marekw1986/MOS6502_computer/hardware/video_and_power.brd

## EAGLE design hardware/video_and_power.brd (2020-09-18)

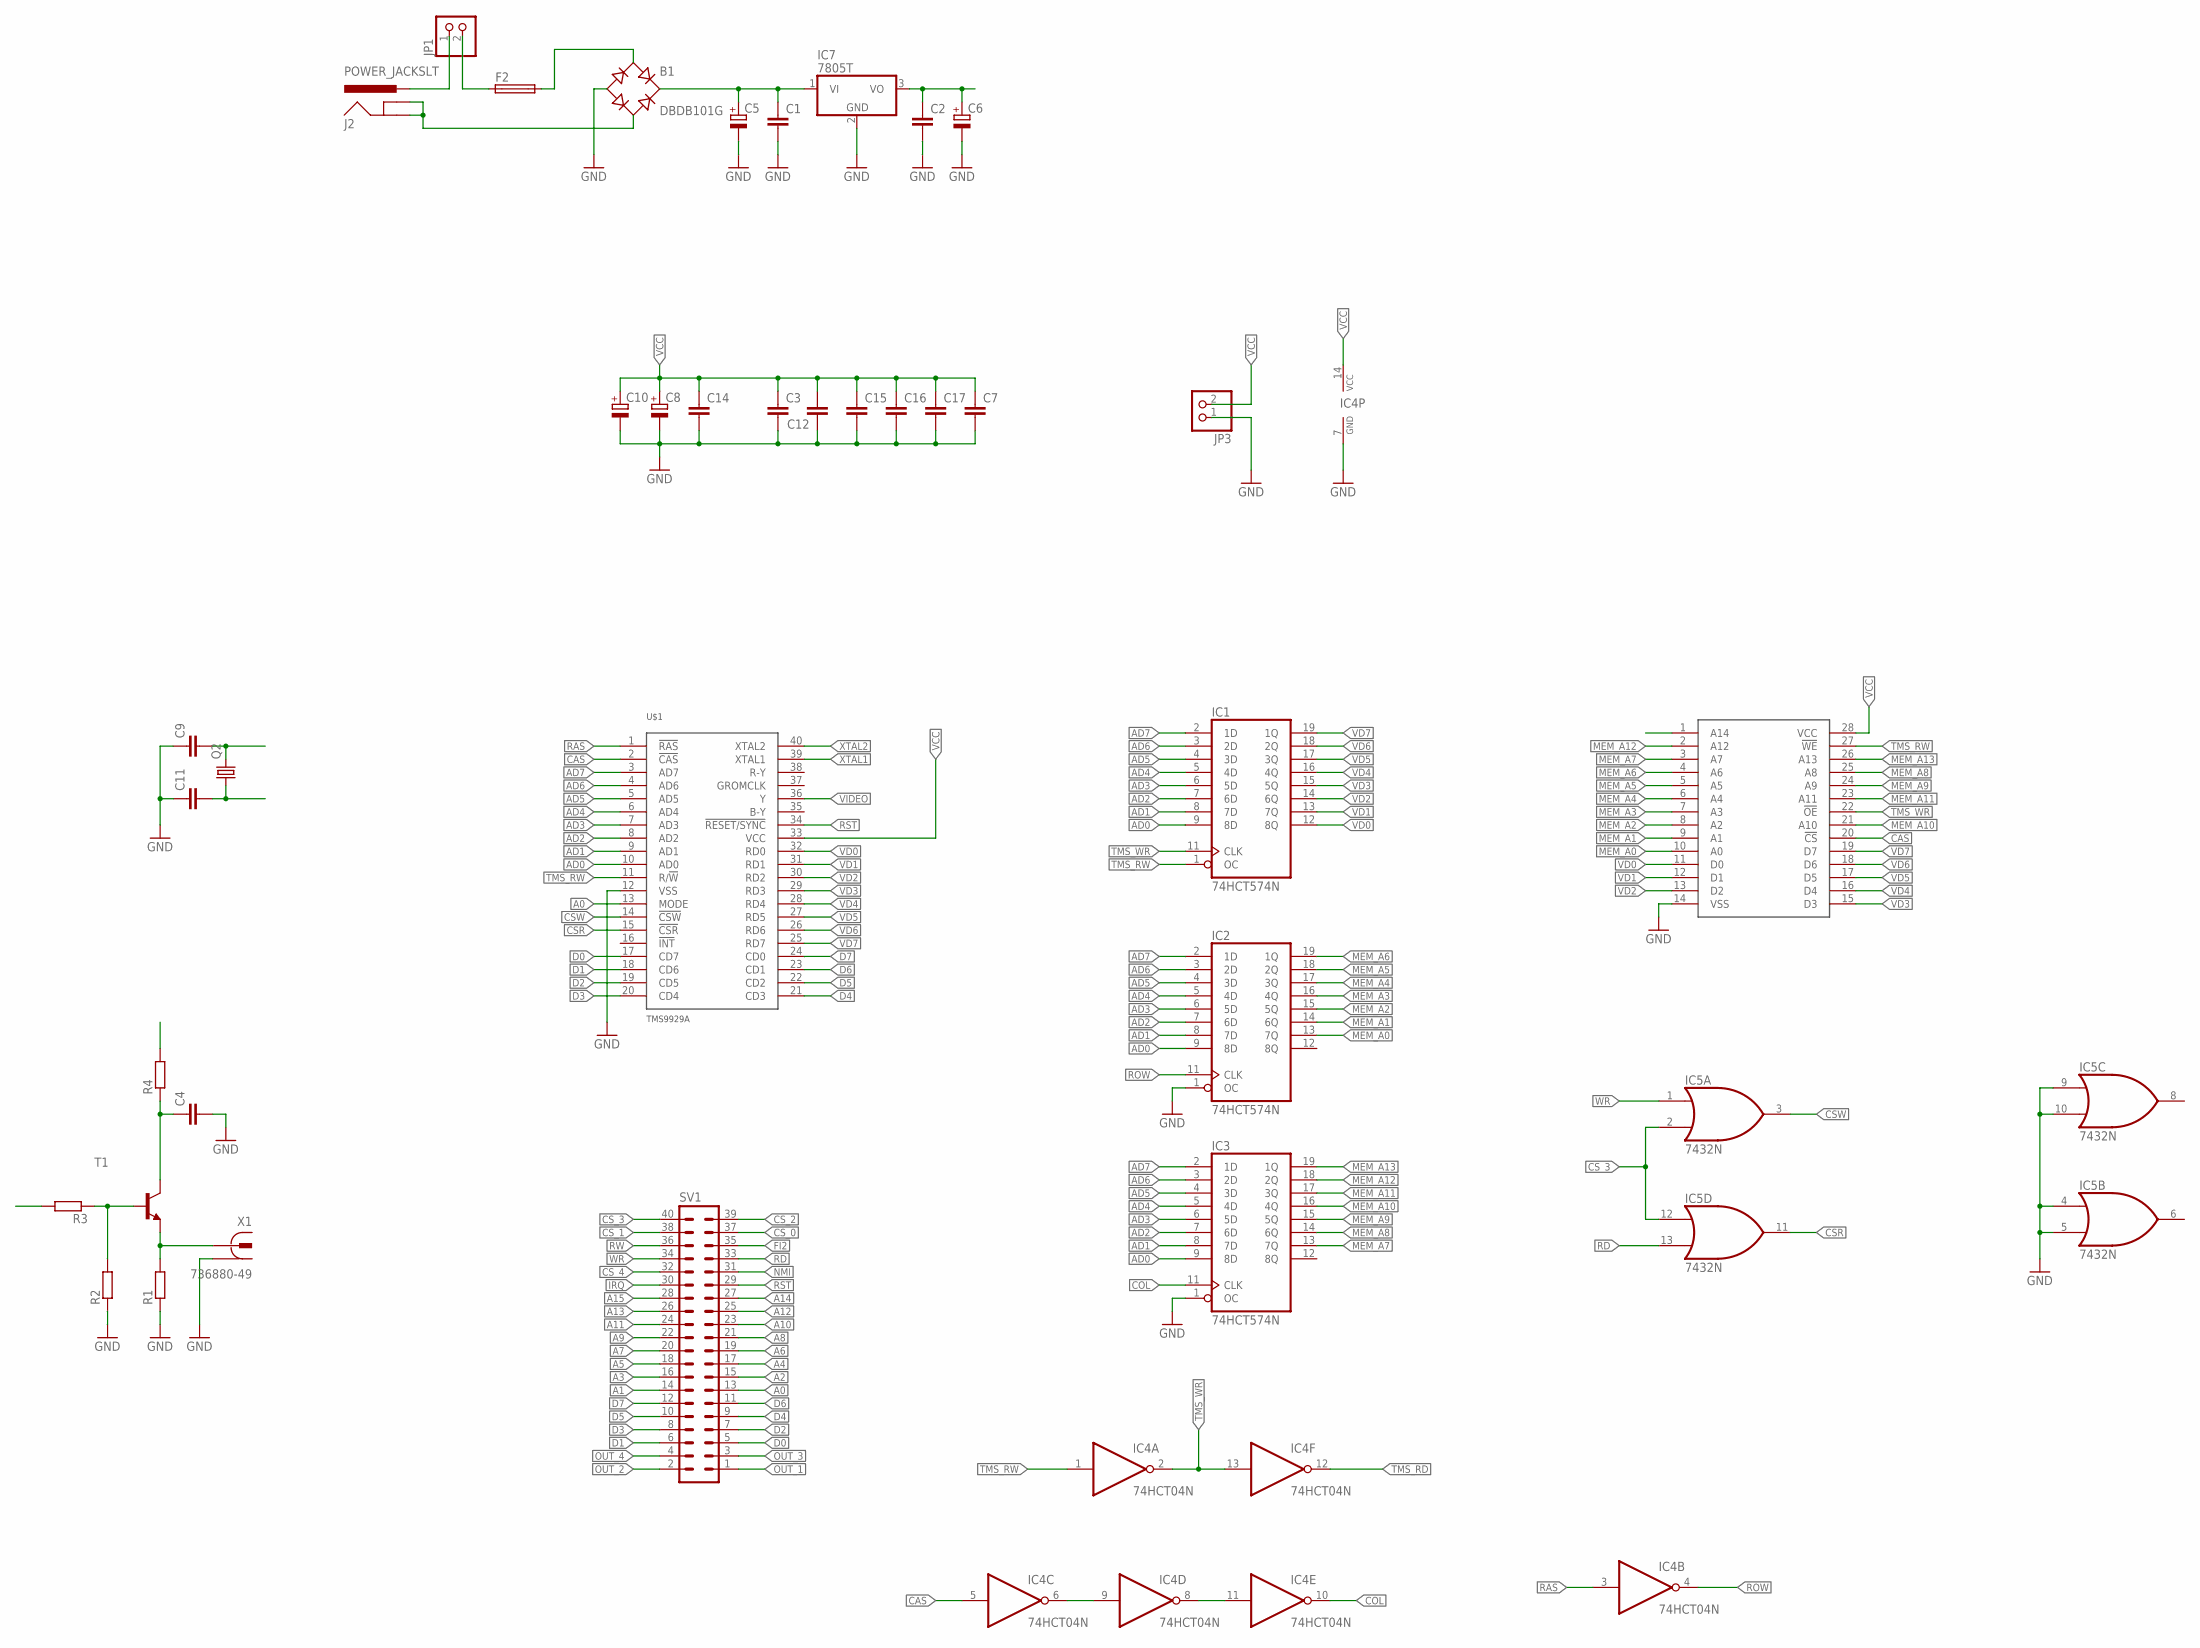
[picture p1: schematic video_and_power.sch]

Parts:
B1: DBDB101G; DB
C1, C2, C7, C14, C15: C-EUC1206; C1206
C3, C4, C9, C11, C12, C16, C17: C-EUC0603; C0603
C5, C6, C8, C10: CPOL-EUE5-10.5; E5-10,5
F2: SH22,5; MPN 0031.8201
IC1, IC2, IC3: 74HCT574N; DIL20
IC4: 74HCT04N; DIL14
IC5: 7432N; DIL14
IC7: 7805T; TO220H
J2: POWER_JACKSLT; POWER_JACK_SLOT
JP1: PINHD-1X2; 1X02
JP3: PINHD-1X2/90; 1X02/90
Q2: CRYSTALHC49S; HC49/S
R1, R2: R-EU_R0603; R0603
R3: R-EU_0204/7; 0204/7
R4: R-EU_R0805; R0805
SV1: ML40L
T1: 2N4401-NPN-TO92-EBC; TO92-EBC
U$1: TMS9929A; DIL40
U$2: 62256; DIL28-6
X1: 736880-49

Connections:
A0: SV1.13, U$1.13 (MODE)
A1: SV1.14
A2: SV1.15
A3: SV1.16
A4: SV1.17
A5: SV1.18
A6: SV1.19
A7: SV1.20
A8: SV1.21
A9: SV1.22
A10: SV1.23
A11: SV1.24
A12: SV1.25
A13: SV1.26
A14: SV1.27
A15: SV1.28
AD0: IC1.9 (8D), IC2.9 (8D), IC3.9 (8D), U$1.10 (AD0)
AD1: IC1.8 (7D), IC2.8 (7D), IC3.8 (7D), U$1.9 (AD1)
AD2: IC1.7 (6D), IC2.7 (6D), IC3.7 (6D), U$1.8 (AD2)
AD3: IC1.6 (5D), IC2.6 (5D), IC3.6 (5D), U$1.7 (AD3)
AD4: IC1.5 (4D), IC2.5 (4D), IC3.5 (4D), U$1.6 (AD4)
AD5: IC1.4 (3D), IC2.4 (3D), IC3.4 (3D), U$1.5 (AD5)
AD6: IC1.3 (2D), IC2.3 (2D), IC3.3 (2D), U$1.4 (AD6)
AD7: IC1.2 (1D), IC2.2 (1D), IC3.2 (1D), U$1.3 (AD7)
CAS: IC4.5 (I), U$1.2 (!CAS), U$2.20 (!CS)
COL: IC3.11 (CLK), IC4.10 (O)
CSR: IC5.11 (O), U$1.15 (!CSR)
CSW: IC5.3 (O), U$1.14 (!CSW)
CS_0: SV1.37
CS_1: SV1.38
CS_2: SV1.39
CS_3: IC5.2 (I1), IC5.12 (I0), SV1.40
CS_4: SV1.32
D0: SV1.5, U$1.17 (CD7)
D1: SV1.6, U$1.18 (CD6)
D2: SV1.7, U$1.19 (CD5)
D3: SV1.8, U$1.20 (CD4)
D4: SV1.9, U$1.21 (CD3)
D5: SV1.10, U$1.22 (CD2)
D6: SV1.11, U$1.23 (CD1)
D7: SV1.12, U$1.24 (CD0)
FI2: SV1.35
GND: B1.-, C1.2, C2.2, C3.2, C4.2, C5.-, C6.-, C7.2, C8.-, C9.1, C10.-, C11.1, C12.1, C14.2, C15.2, C16.2, C17.2, IC1.10 (GND), IC2.1 (OC), IC2.10 (GND), IC3.1 (OC), IC3.10 (GND), IC4.7 (GND), IC5.4 (I0), IC5.5 (I1), IC5.7 (GND), IC5.9 (I0), IC5.10 (I1), IC7.2 (GND), JP3.1, R1.1, R2.1, U$1.12 (VSS), U$2.14 (VSS), X1.1, X1.1@1 (1), X1.1@2 (1)
IRQ: SV1.30
MEM_A0: IC2.13 (7Q), U$2.10 (A0)
MEM_A1: IC2.14 (6Q), U$2.9 (A1)
MEM_A2: IC2.15 (5Q), U$2.8 (A2)
MEM_A3: IC2.16 (4Q), U$2.7 (A3)
MEM_A4: IC2.17 (3Q), U$2.6 (A4)
MEM_A5: IC2.18 (2Q), U$2.5 (A5)
MEM_A6: IC2.19 (1Q), U$2.4 (A6)
MEM_A7: IC3.13 (7Q), U$2.3 (A7)
MEM_A8: IC3.14 (6Q), U$2.25 (A8)
MEM_A9: IC3.15 (5Q), U$2.24 (A9)
MEM_A10: IC3.16 (4Q), U$2.21 (A10)
MEM_A11: IC3.17 (3Q), U$2.23 (A11)
MEM_A12: IC3.18 (2Q), U$2.2 (A12)
MEM_A13: IC3.19 (1Q), U$2.26 (A13)
unnamed: IC4.6 (O), IC4.9 (I)
unnamed: IC4.8 (O), IC4.11 (I)
unnamed: B1.AC1, F2.2
unnamed: J2.PWR, JP1.1
unnamed: R1.2, T1.E, X1.2
unnamed: R2.2, R3.1, T1.B
unnamed: C4.1, R4.1, T1.C
unnamed: B1.AC2, J2.GND@1 (GNDBREAK), J2.GND@2 (GND)
unnamed: F2.1, JP1.2
unnamed: B1.+, C1.1, C5.+, IC7.1 (VI)
NMI: SV1.31
OUT_1: SV1.1
OUT_2: SV1.2
OUT_3: SV1.3, U$2.1 (A14)
OUT_4: SV1.4
RAS: IC4.3 (I), U$1.1 (!RAS)
RD: IC5.13 (I1), SV1.33
ROW: IC2.11 (CLK), IC4.4 (O)
RST: SV1.29, U$1.34 (!RESET/SYNC)
RW: SV1.36
TMS_RD: IC4.12 (O)
TMS_RW: IC1.1 (OC), IC4.1 (I), U$1.11 (R/!W), U$2.27 (!WE)
TMS_WR: IC1.11 (CLK), IC4.2 (O), IC4.13 (I), U$2.22 (!OE)
VCC: C2.1, C3.1, C6.+, C7.1, C8.+, C10.+, C12.2, C14.1, C15.1, C16.1, C17.1, IC1.20 (VCC), IC2.20 (VCC), IC3.20 (VCC), IC4.14 (VCC), IC5.14 (VCC), IC7.3 (VO), JP3.2, R4.2, U$1.33 (VCC), U$2.28 (VCC)
VD0: IC1.12 (8Q), U$1.32 (RD0), U$2.11 (D0)
VD1: IC1.13 (7Q), U$1.31 (RD1), U$2.12 (D1)
VD2: IC1.14 (6Q), U$1.30 (RD2), U$2.13 (D2)
VD3: IC1.15 (5Q), U$1.29 (RD3), U$2.15 (D3)
VD4: IC1.16 (4Q), U$1.28 (RD4), U$2.16 (D4)
VD5: IC1.17 (3Q), U$1.27 (RD5), U$2.17 (D5)
VD6: IC1.18 (2Q), U$1.26 (RD6), U$2.18 (D6)
VD7: IC1.19 (1Q), U$1.25 (RD7), U$2.19 (D7)
VIDEO: R3.2, U$1.36 (Y)
WR: IC5.1 (I0), SV1.34
XTAL1: C9.2, Q2.2, U$1.39 (XTAL1)
XTAL2: C11.2, Q2.1, U$1.40 (XTAL2)

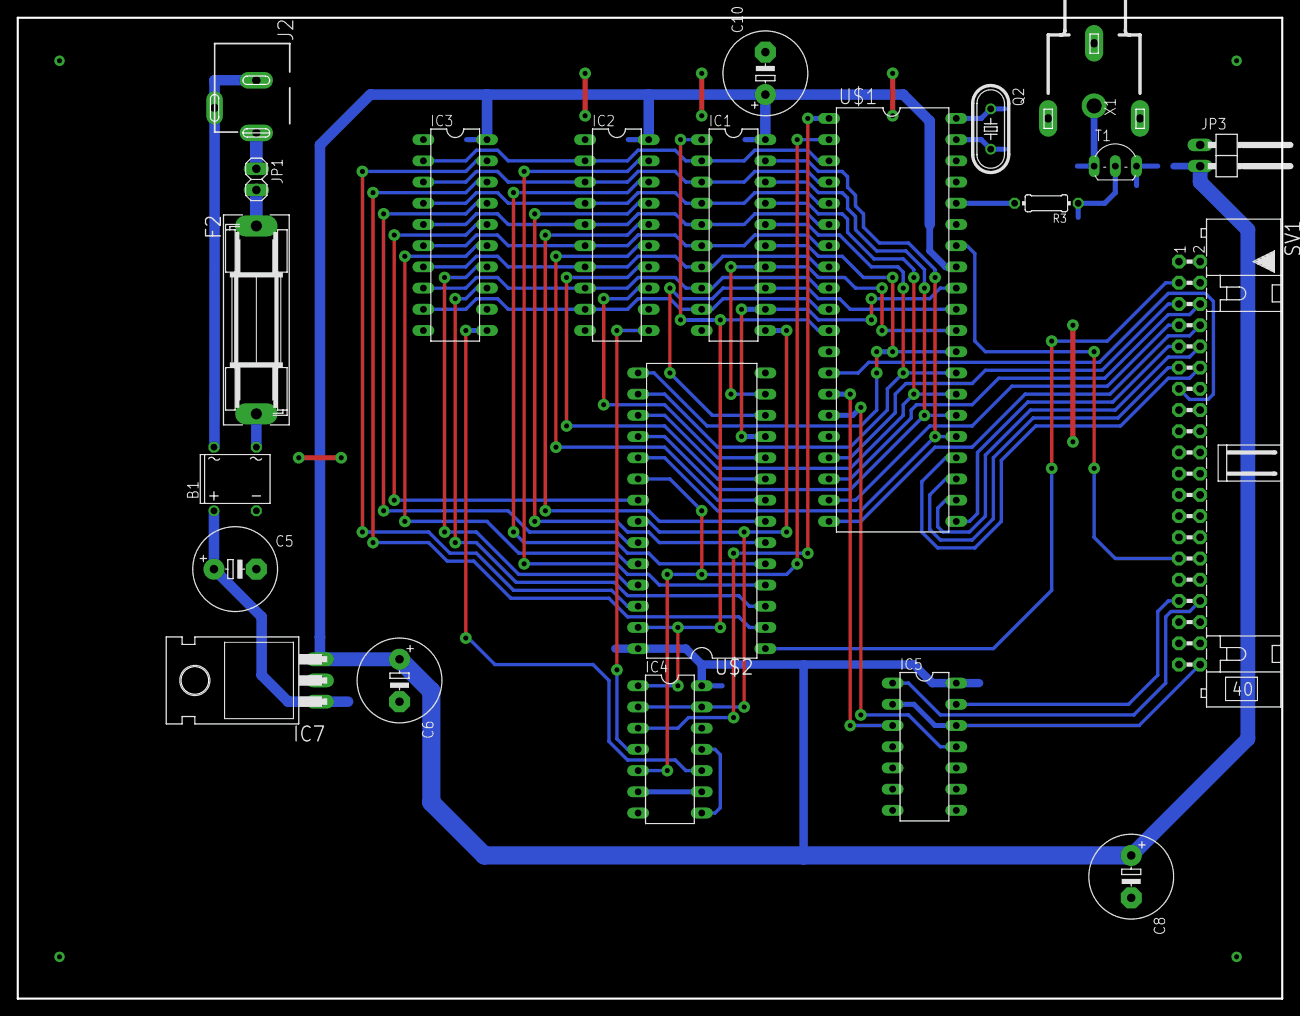
[picture p2: board video_and_power.brd from above]

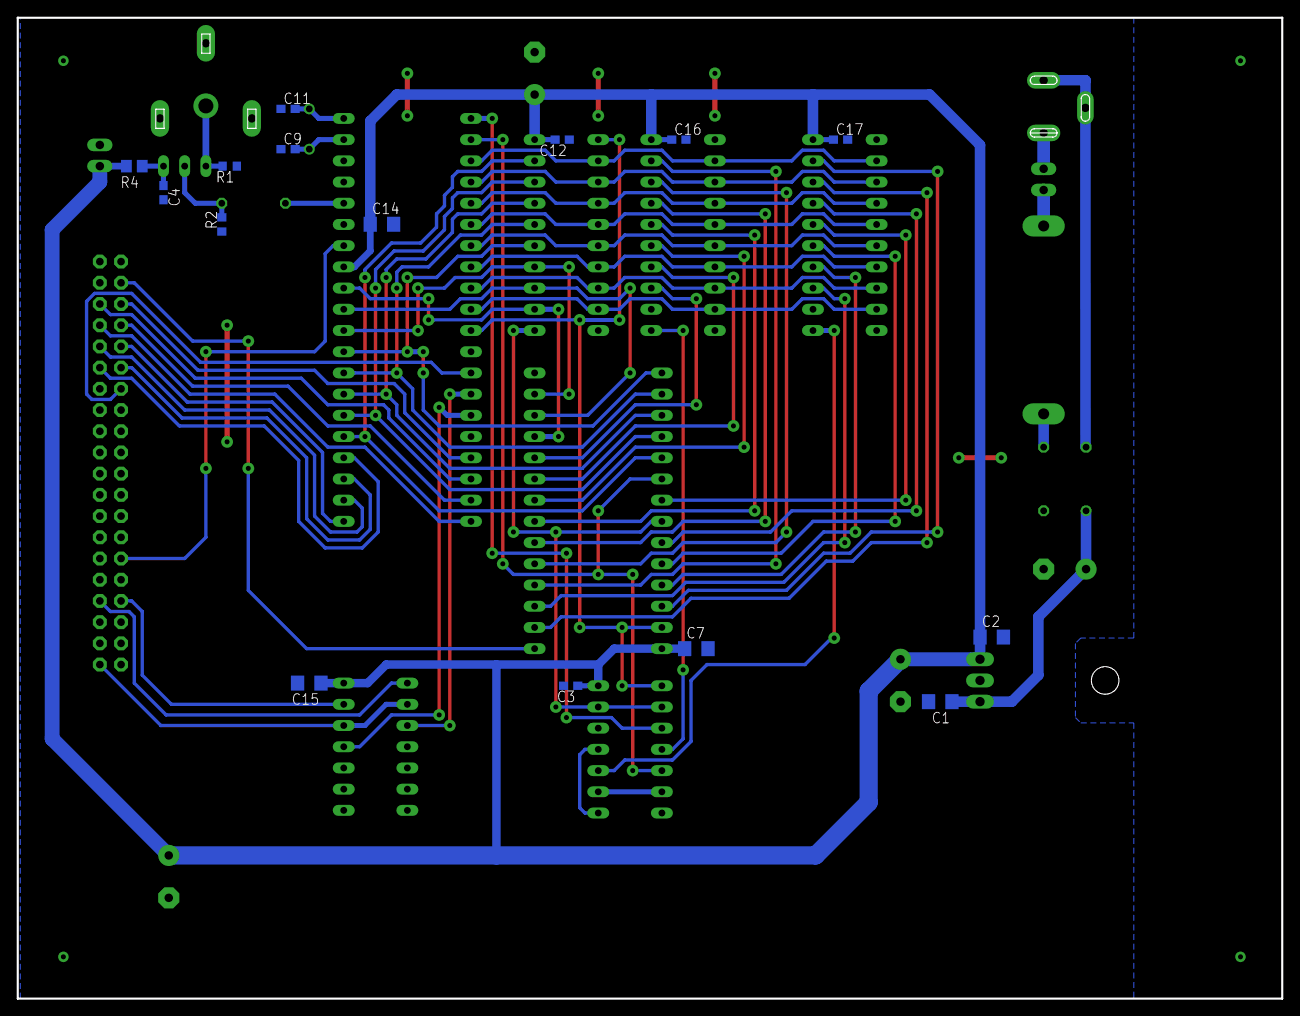
[picture p3: board video_and_power.brd from below]

Board: 2 copper layers, 151.4 x 117.5 mm, 37 parts (15 on the bottom side), 67 nets.
