marekw1986/MOS6502_computer/hardware/cpu_board.brd

## EAGLE design hardware/cpu_board.brd (2020-09-18)

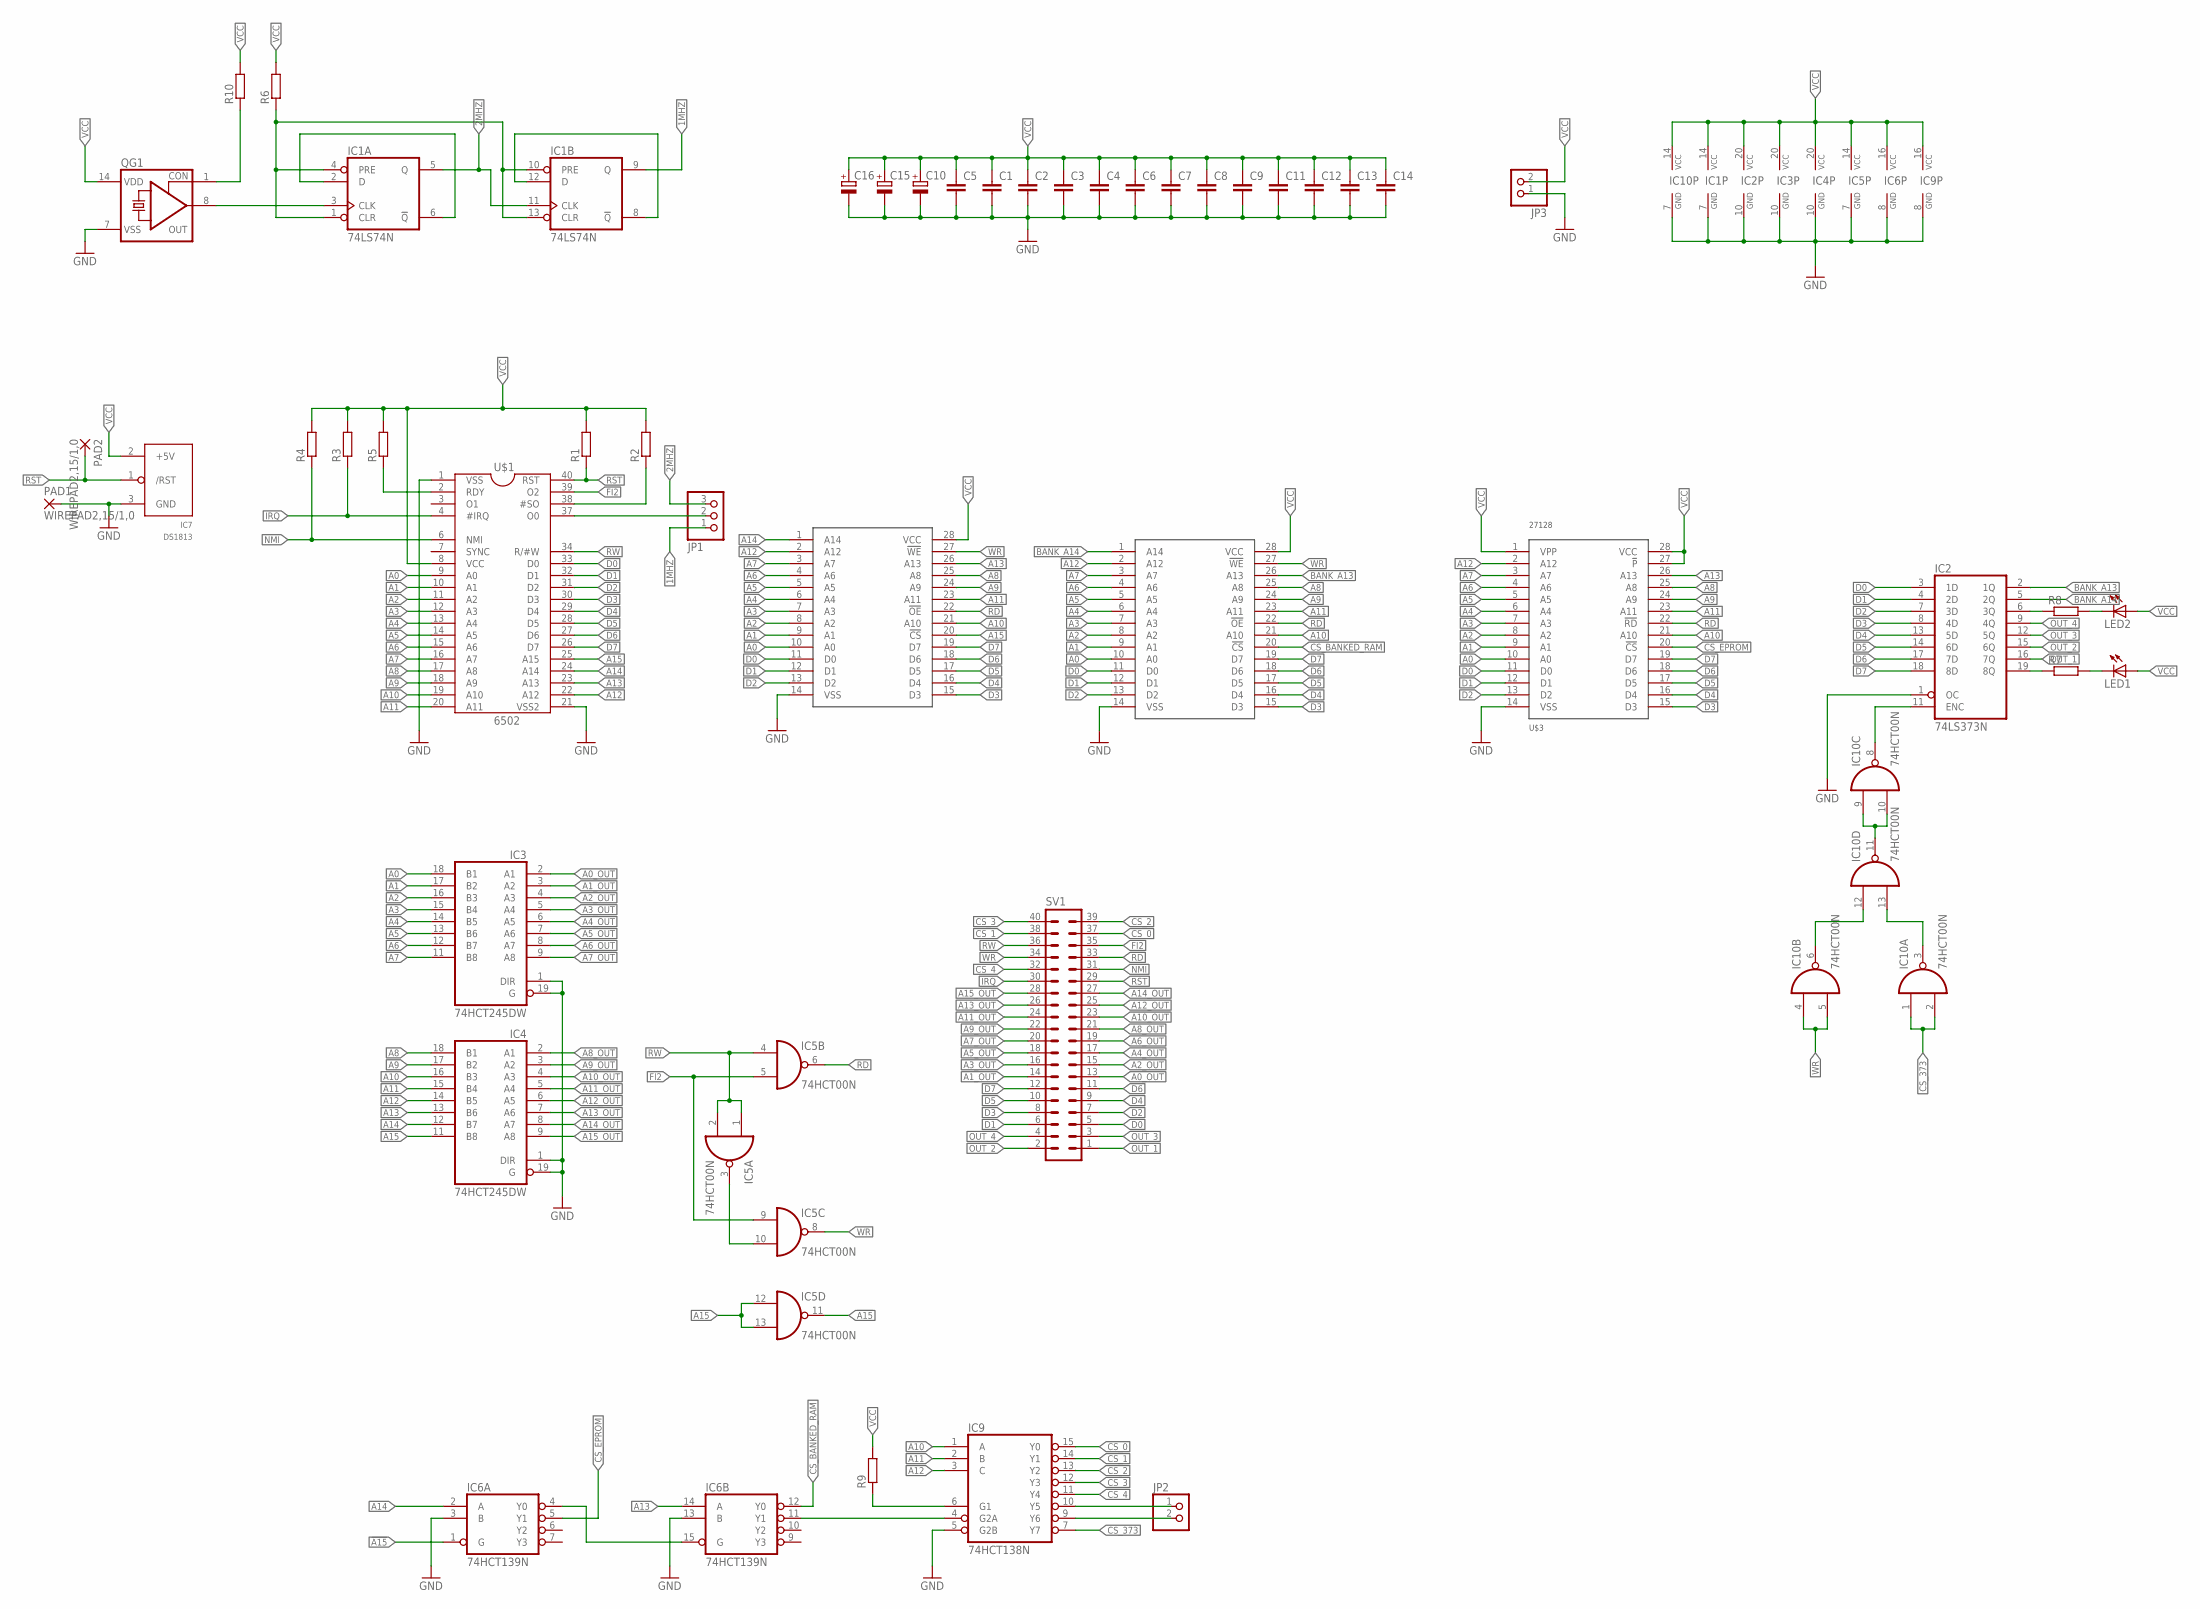
[picture p4: schematic cpu_board.sch]

Parts:
C1, C2, C3, C4, C6, C8, C9: C-EUC1206; C1206
C5, C7, C14: C-EUC0603; C0603
C10: CPOL-EUE5-10.5; E5-10,5
C11, C12, C13: C-EUC0805; C0805
C15, C16: CPOL-EUSMCB; SMC_B
IC1: 74LS74N; DIL14
IC2: 74LS373N; DIL20
IC3, IC4: 74HCT245DW; SO20W
IC5, IC10: 74HCT00N; DIL14
IC6: 74HCT139N; DIL16
IC7: DS1813; TO-92
IC9: 74HCT138N; DIL16
JP1: PINHD-1X3; 1X03
JP2, JP3: PINHD-1X2/90; 1X02/90
LED1, LED2: LED5MM
PAD1, PAD2: WIREPAD2,15/1,0; 2,15/1,0
QG1: CRYSTAL_RES-SG51; SG51
R1, R2, R3, R4, R5, R7, R8, R10: R-EU_R1206; R1206
R6: R-EU_M1206; M1206
R9: R-EU_0204/7; 0204/7
SV1: ML40L
U$1: 6502; DIL40
U$2, U$4: 62256; DIL28-6
U$3: 27128; DIL28

Connections:
1MHZ: IC1.9 (Q), JP1.1
2MHZ: IC1.5 (Q), IC1.11 (CLK), JP1.3
!A15: IC5.11 (O), IC6.1 (G)
A0: IC3.18 (B1), U$1.9 (A0), U$2.10 (A0), U$3.10 (A0), U$4.10 (A0)
A0_OUT: IC3.2 (A1), SV1.13
A1: IC3.17 (B2), U$1.10 (A1), U$2.9 (A1), U$3.9 (A1), U$4.9 (A1)
A1_OUT: IC3.3 (A2), SV1.14
A2: IC3.16 (B3), U$1.11 (A2), U$2.8 (A2), U$3.8 (A2), U$4.8 (A2)
A2_OUT: IC3.4 (A3), SV1.15
A3: IC3.15 (B4), U$1.12 (A3), U$2.7 (A3), U$3.7 (A3), U$4.7 (A3)
A3_OUT: IC3.5 (A4), SV1.16
A4: IC3.14 (B5), U$1.13 (A4), U$2.6 (A4), U$3.6 (A4), U$4.6 (A4)
A4_OUT: IC3.6 (A5), SV1.17
A5: IC3.13 (B6), U$1.14 (A5), U$2.5 (A5), U$3.5 (A5), U$4.5 (A5)
A5_OUT: IC3.7 (A6), SV1.18
A6: IC3.12 (B7), U$1.15 (A6), U$2.4 (A6), U$3.4 (A6), U$4.4 (A6)
A6_OUT: IC3.8 (A7), SV1.19
A7: IC3.11 (B8), U$1.16 (A7), U$2.3 (A7), U$3.3 (A7), U$4.3 (A7)
A7_OUT: IC3.9 (A8), SV1.20
A8: IC4.18 (B1), U$1.17 (A8), U$2.25 (A8), U$3.25 (A8), U$4.25 (A8)
A8_OUT: IC4.2 (A1), SV1.21
A9: IC4.17 (B2), U$1.18 (A9), U$2.24 (A9), U$3.24 (A9), U$4.24 (A9)
A9_OUT: IC4.3 (A2), SV1.22
A10: IC4.16 (B3), IC9.1 (A), U$1.19 (A10), U$2.21 (A10), U$3.21 (A10), U$4.21 (A10)
A10_OUT: IC4.4 (A3), SV1.23
A11: IC4.15 (B4), IC9.2 (B), U$1.20 (A11), U$2.23 (A11), U$3.23 (A11), U$4.23 (A11)
A11_OUT: IC4.5 (A4), SV1.24
A12: IC4.14 (B5), IC9.3 (C), U$1.22 (A12), U$2.2 (A12), U$3.2 (A12), U$4.2 (A12)
A12_OUT: IC4.6 (A5), SV1.25
A13: IC4.13 (B6), IC6.14 (A), U$1.23 (A13), U$3.26 (A13), U$4.26 (A13)
A13_OUT: IC4.7 (A6), SV1.26
A14: IC4.12 (B7), IC6.2 (A), U$1.24 (A14), U$4.1 (A14)
A14_OUT: IC4.8 (A7), SV1.27
A15: IC4.11 (B8), IC5.12 (I0), IC5.13 (I1), U$1.25 (A15), U$4.20 (!CS)
A15_OUT: IC4.9 (A8), SV1.28
BANK_A13: IC2.2 (1Q), U$2.26 (A13)
BANK_A14: IC2.5 (2Q), U$2.1 (A14)
CS_0: IC9.15 (Y0), SV1.37
CS_1: IC9.14 (Y1), SV1.38
CS_2: IC9.13 (Y2), SV1.39
CS_3: IC9.12 (Y3), SV1.40
CS_4: IC9.11 (Y4), SV1.32
CS_373: IC9.7 (Y7), IC10.1 (I0), IC10.2 (I1)
CS_BANKED_RAM: IC6.12 (Y0), U$2.20 (!CS)
CS_EPROM: IC6.5 (Y1), U$3.20 (!CS)
D0: IC2.3 (1D), SV1.5, U$1.33 (D0), U$2.11 (D0), U$3.11 (D0), U$4.11 (D0)
D1: IC2.4 (2D), SV1.6, U$1.32 (D1), U$2.12 (D1), U$3.12 (D1), U$4.12 (D1)
D2: IC2.7 (3D), SV1.7, U$1.31 (D2), U$2.13 (D2), U$3.13 (D2), U$4.13 (D2)
D3: IC2.8 (4D), SV1.8, U$1.30 (D3), U$2.15 (D3), U$3.15 (D3), U$4.15 (D3)
D4: IC2.13 (5D), SV1.9, U$1.29 (D4), U$2.16 (D4), U$3.16 (D4), U$4.16 (D4)
D5: IC2.14 (6D), SV1.10, U$1.28 (D5), U$2.17 (D5), U$3.17 (D5), U$4.17 (D5)
D6: IC2.17 (7D), SV1.11, U$1.27 (D6), U$2.18 (D6), U$3.18 (D6), U$4.18 (D6)
D7: IC2.18 (8D), SV1.12, U$1.26 (D7), U$2.19 (D7), U$3.19 (D7), U$4.19 (D7)
FI2: IC5.5 (I1), IC5.9 (I0), SV1.35, U$1.39 (O2)
GND: C1.2, C2.2, C3.2, C4.2, C5.2, C6.2, C7.2, C8.2, C9.2, C10.-, C11.2, C12.2, C13.2, C14.2, C15.-, C16.-, IC1.7 (GND), IC2.1 (OC), IC2.10 (GND), IC3.1 (DIR), IC3.10 (GND), IC3.19 (G), IC4.1 (DIR), IC4.10 (GND), IC4.19 (G), IC5.7 (GND), IC6.3 (B), IC6.8 (GND), IC6.13 (B), IC7.3 (GND), IC9.5 (G2B), IC9.8 (GND), IC10.7 (GND), JP3.1, PAD1.1, QG1.7 (VSS), U$1.1 (VSS), U$1.21 (VSS2), U$2.14 (VSS), U$3.14 (VSS), U$4.14 (VSS)
IRQ: R3.1, SV1.30, U$1.4 (#IRQ)
unnamed: IC1.1 (CLR), IC1.4 (PRE), IC1.10 (PRE), IC1.13 (CLR), R6.1
unnamed: R2.1, U$1.38 (#SO)
unnamed: IC2.19 (8Q), R7.1
unnamed: LED1.K (C), R7.2
unnamed: R5.1, U$1.2 (RDY)
unnamed: JP1.2, U$1.37 (O0)
unnamed: QG1.1 (CON), R10.1
unnamed: IC1.3 (CLK), QG1.8 (OUT)
unnamed: IC1.2 (D), IC1.6 (!Q)
unnamed: IC1.8 (!Q), IC1.12 (D)
unnamed: IC2.11 (ENC), IC10.8 (O)
unnamed: IC10.9 (I0), IC10.10 (I1), IC10.11 (O)
unnamed: IC10.3 (O), IC10.13 (I1)
unnamed: IC10.6 (O), IC10.12 (I0)
unnamed: IC2.6 (3Q), R8.1
unnamed: IC9.10 (Y5), JP2.1
unnamed: LED2.K (C), R8.2
unnamed: IC5.3 (O), IC5.10 (I1)
unnamed: IC6.4 (Y0), IC6.15 (G)
unnamed: IC9.6 (G1), R9.1
unnamed: IC6.11 (Y1), IC9.4 (G2A)
unnamed: IC9.9 (Y6), JP2.2
NMI: R4.1, SV1.31, U$1.6 (NMI)
OUT_1: IC2.16 (7Q), SV1.1
OUT_2: IC2.15 (6Q), SV1.2
OUT_3: IC2.12 (5Q), SV1.3
OUT_4: IC2.9 (4Q), SV1.4
RD: IC5.6 (O), SV1.33, U$2.22 (!OE), U$3.22 (!RD), U$4.22 (!OE)
RST: IC7.1 (/RST), PAD2.1, R1.1, SV1.29, U$1.40 (RST)
RW: IC5.1 (I0), IC5.2 (I1), IC5.4 (I0), SV1.36, U$1.34 (R/#W)
VCC: C1.1, C2.1, C3.1, C4.1, C5.1, C6.1, C7.1, C8.1, C9.1, C10.+, C11.1, C12.1, C13.1, C14.1, C15.+, C16.+, IC1.14 (VCC), IC2.20 (VCC), IC3.20 (VCC), IC4.20 (VCC), IC5.14 (VCC), IC6.16 (VCC), IC7.2 (+5V), IC9.16 (VCC), IC10.14 (VCC), JP3.2, LED1.A, LED2.A, QG1.14 (VDD), R1.2, R2.2, R3.2, R4.2, R5.2, R6.2, R9.2, R10.2, U$1.8 (VCC), U$2.28 (VCC), U$3.1 (VPP), U$3.27 (!P), U$3.28 (VCC), U$4.28 (VCC)
WR: IC5.8 (O), IC10.4 (I0), IC10.5 (I1), SV1.34, U$2.27 (!WE), U$4.27 (!WE)

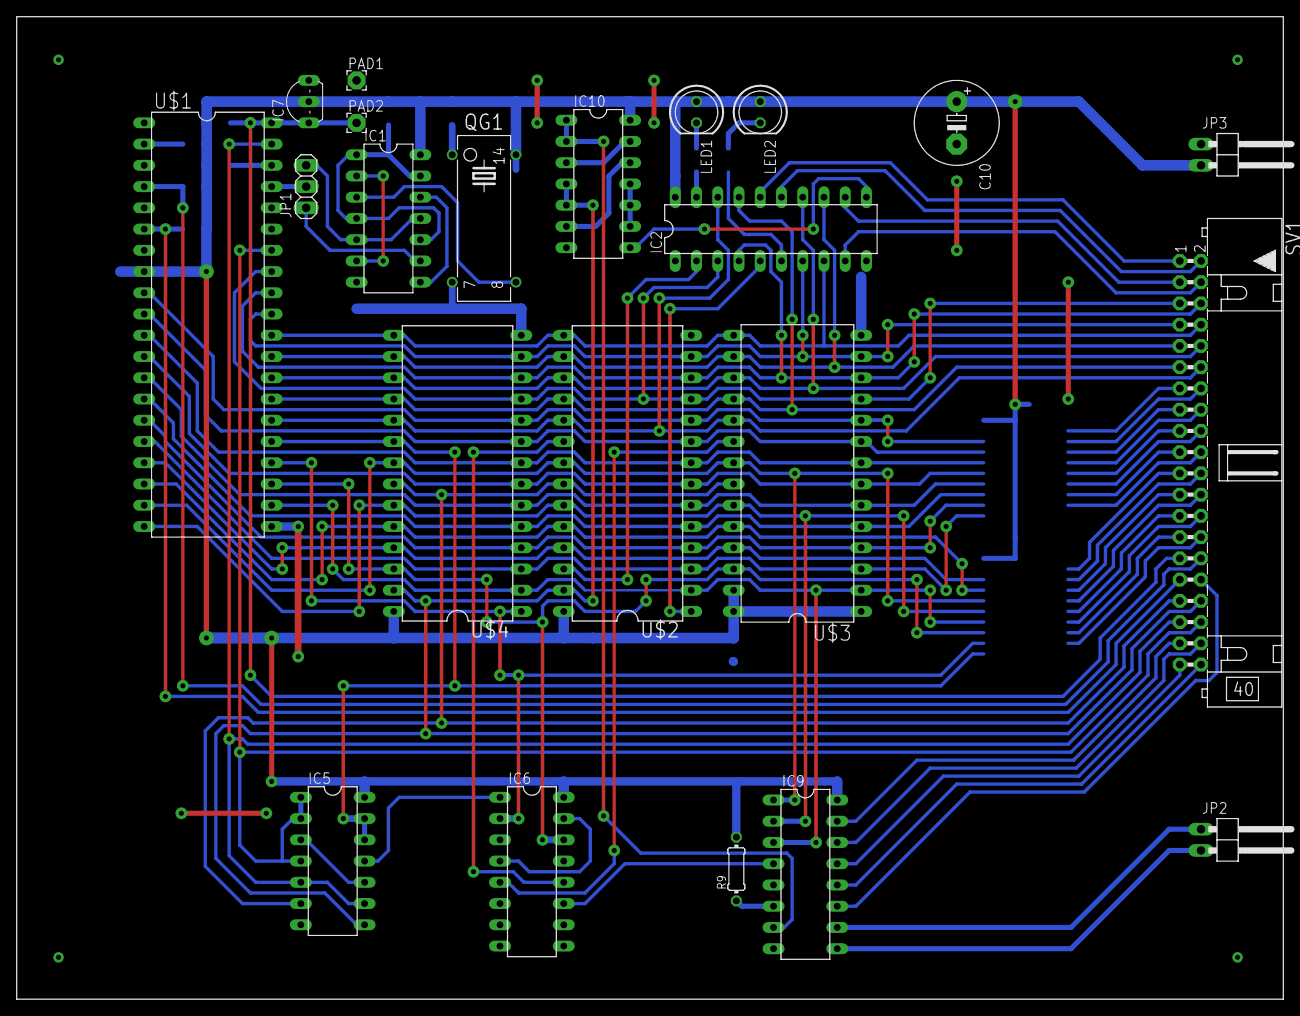
[picture p5: board cpu_board.brd from above]

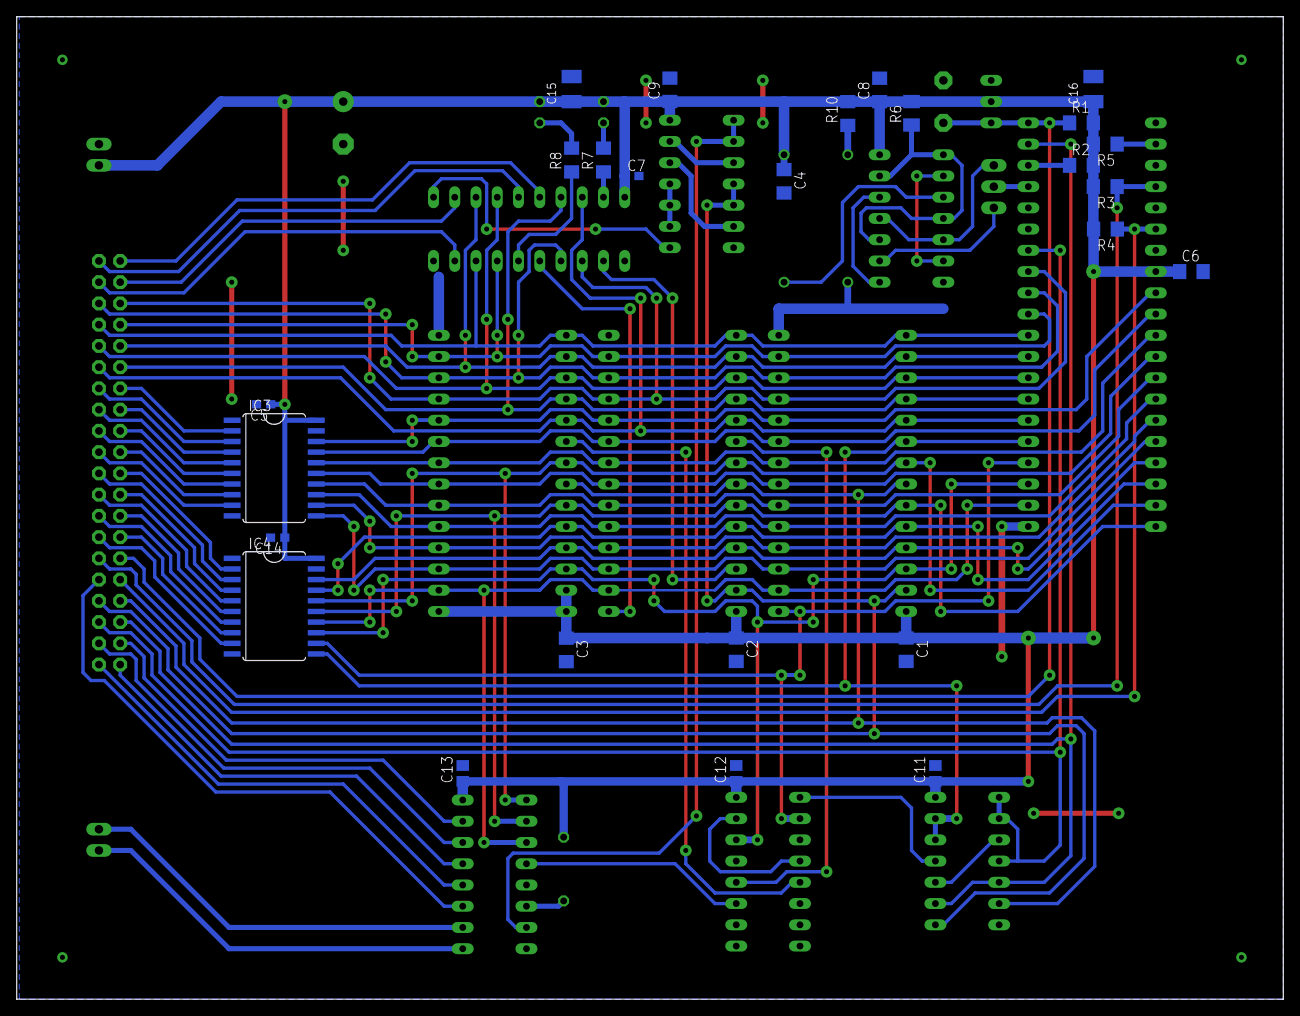
[picture p6: board cpu_board.brd from below]

Board: 2 copper layers, 151.4 x 117.5 mm, 48 parts (26 on the bottom side), 88 nets.
