marekw1986/MOS6502_computer/hardware/io_board.brd

## EAGLE design hardware/io_board.brd (2020-09-18)

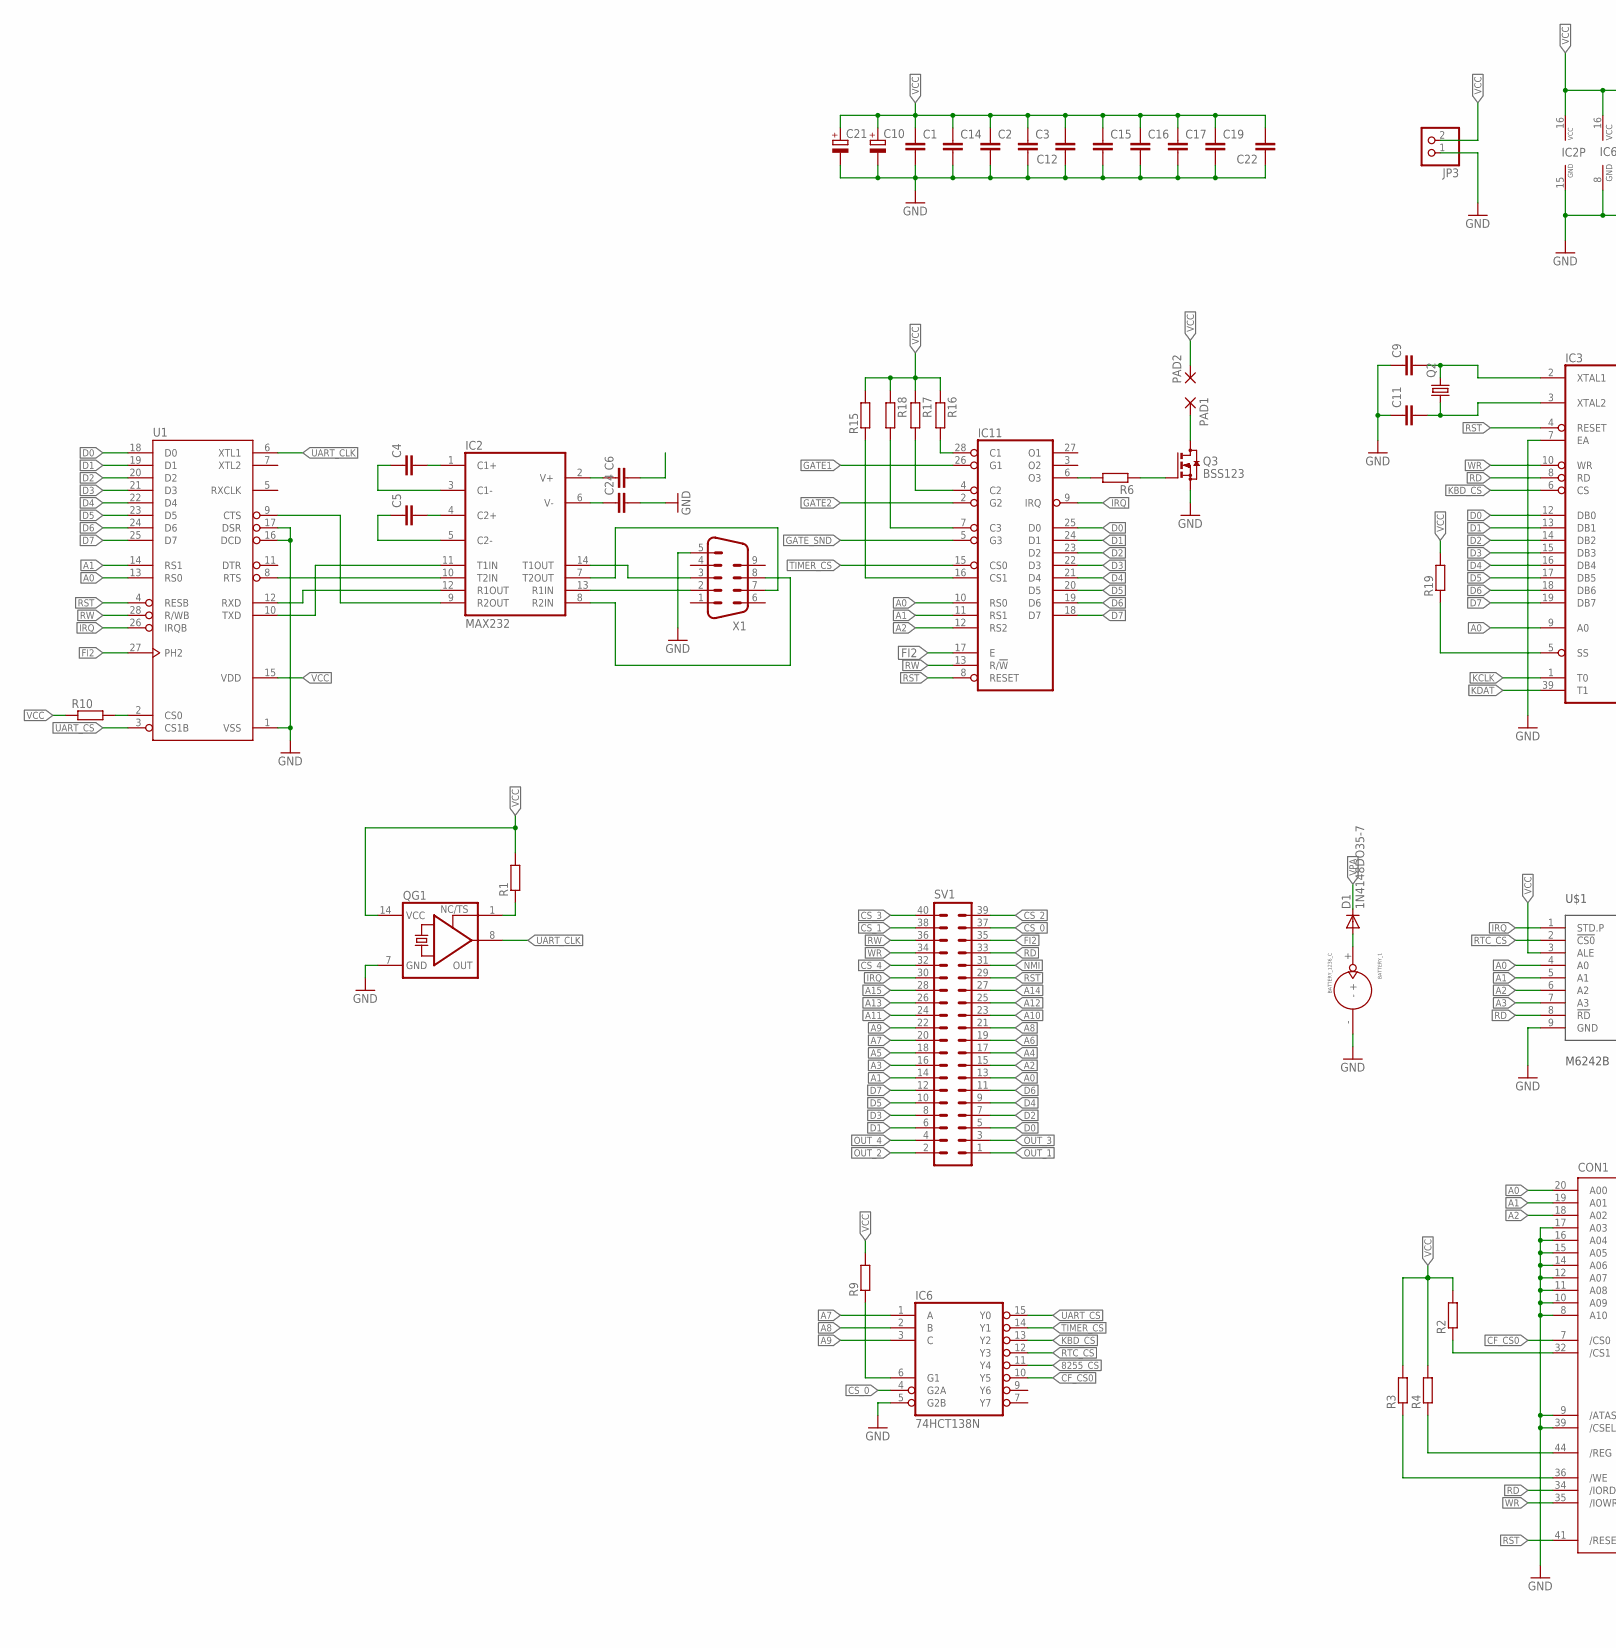
[picture p7: schematic io_board.sch, part in row 1, column 1]

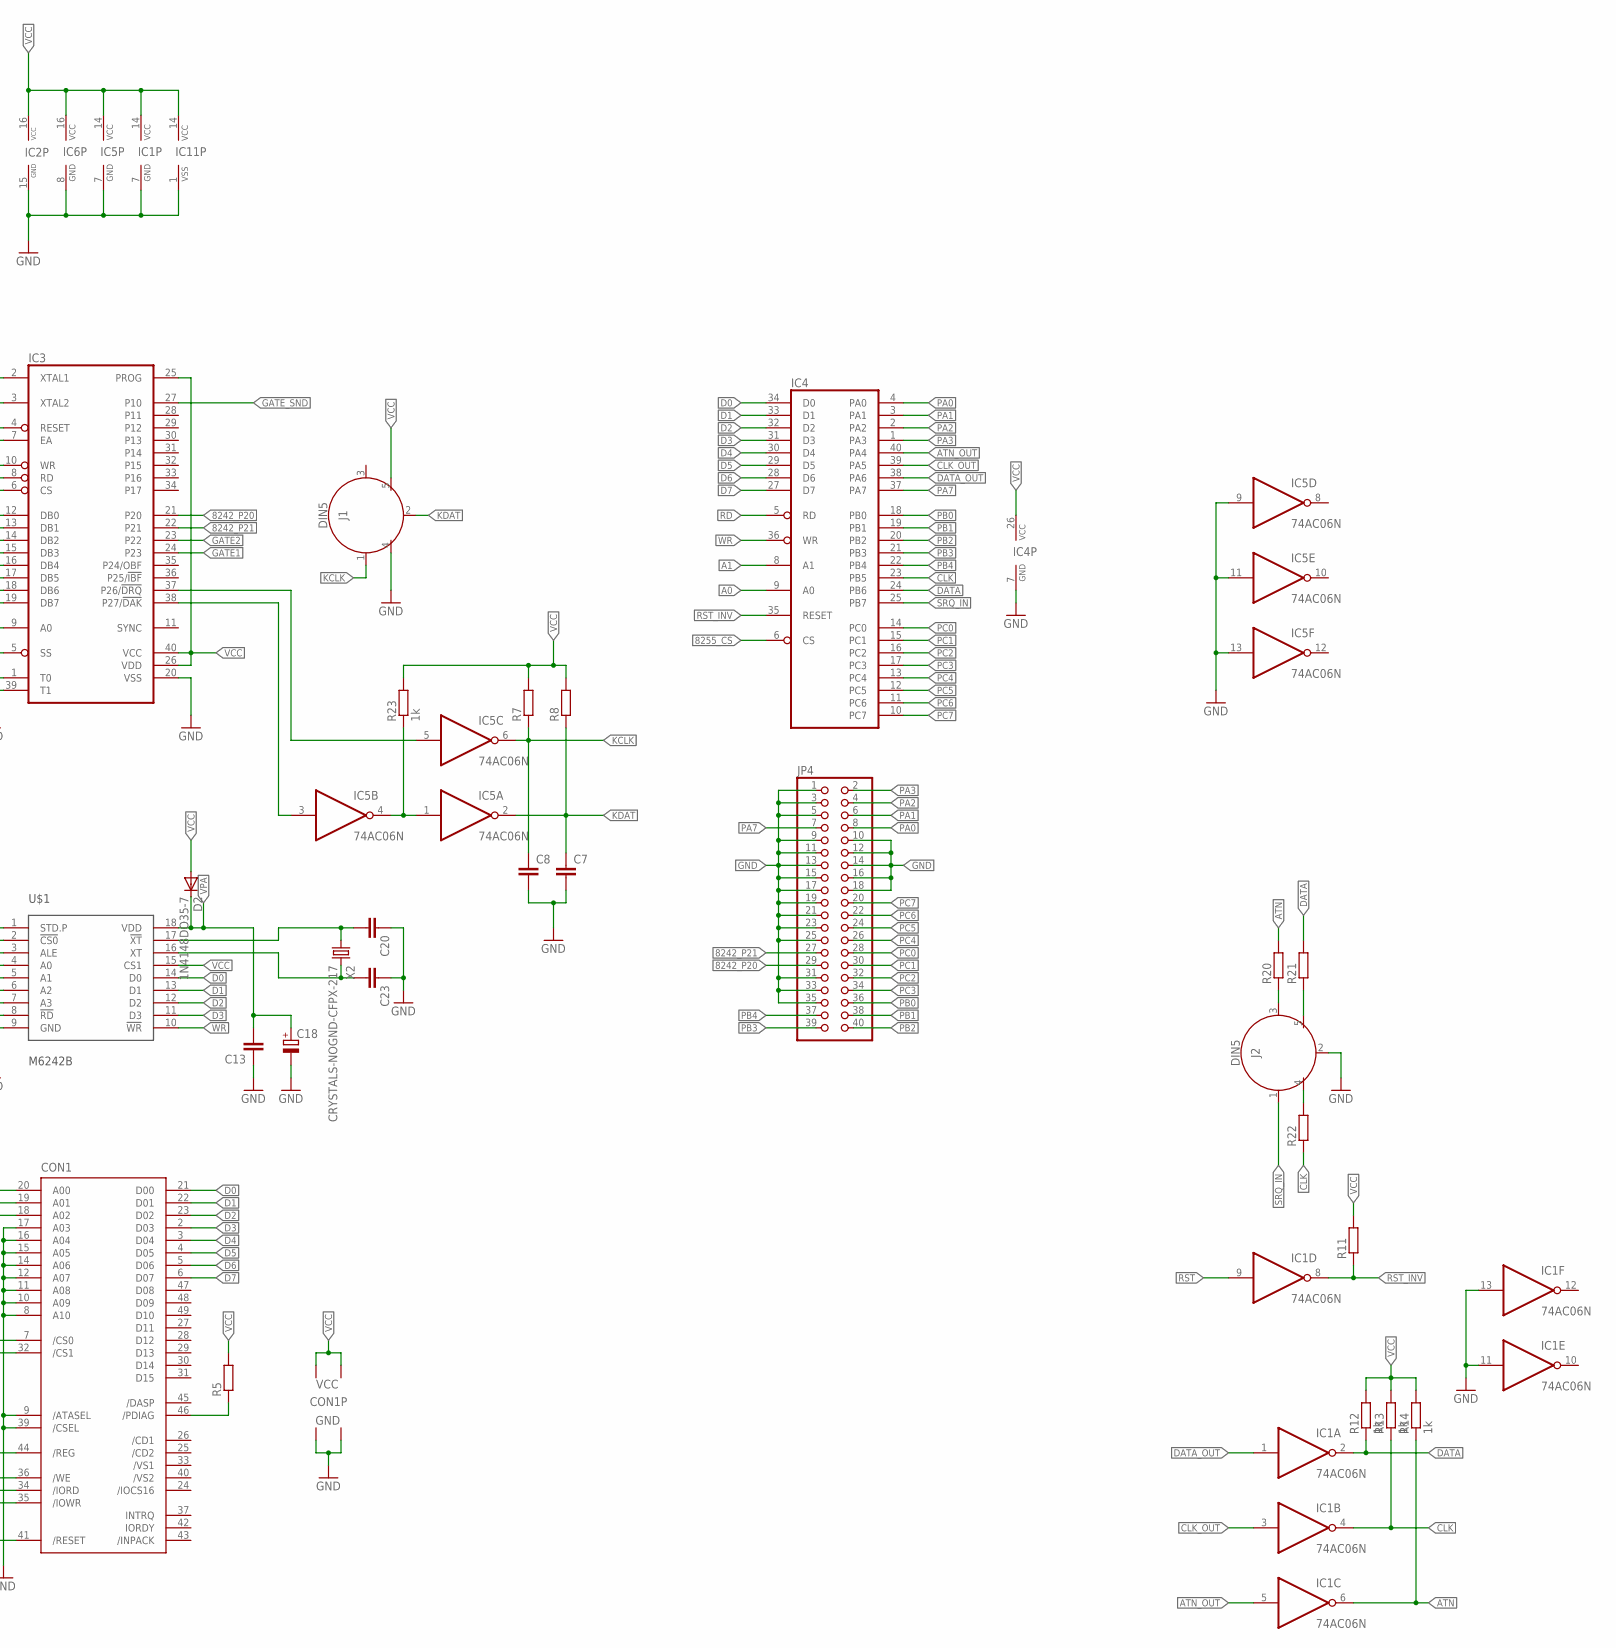
[picture p8: schematic io_board.sch, part in row 1, column 2]

Parts:
BATTERY_1: BATTERY_1236_C
C1, C2, C3, C14, C15, C16, C17: C-EUC1206; C1206
C4, C5, C6, C7, C8, C9, C11, C12, C13, C19, C20, C22, C23, C24: C-EUC0603; C0603
C10: CPOL-EUE5-10.5; E5-10,5
C18, C21: CPOL-EUSMCB; SMC_B
CON1: CF-CARD-IDE_MODE; MI20-50PD-SF
D1, D2: 1N4148DO35-7; DO35-7
IC1, IC5: 74AC06N; DIL14
IC2: MAX232; DIL16
IC3: UPI-8042AH; DIL40
IC4: 8255A; DIL40
IC6: 74HCT138N; DIL16
IC11: 6840; DIL28
J1, J2: DIN5; DIN5-RA-PTH
JP3: PINHD-1X2/90; 1X02/90
JP4: PINHD-2X20; 2X20
PAD1, PAD2: 2,15/1,0
Q2: CRYSTALHC49S; HC49/S
Q3: BSS123; SOT23
QG1: XO-14; DIL14S
R1, R9: R-EU_R1206; R1206
R2, R3, R4, R5, R6, R7, R8, R10, R11, R15, R17, R18: R-EU_R0603; R0603
R12, R14, R23: 1k; 0204/7
R13: 1k; 0204/5
R16, R19: R-EU_0204/5; 0204/5
R20, R21, R22: R-EU_R0805; R0805
SV1: ML40L
U1: G65SC51P; DIP-28
U$1: M6242B; DIL18
X1: M09HP
X2: CRYSTALS-NOGND-CFPX-217; 3.2X1.5-2-PAD

Connections:
8242_P20: IC3.21 (P20), JP4.29
8242_P21: IC3.22 (P21), JP4.27
8255_CS: IC4.6 (CS), IC6.11 (Y4)
A0: CON1.20 (A00), IC3.9 (A0), IC4.9 (A0), IC11.10 (RS0), SV1.13, U1.13 (RS0), U$1.4 (A0)
A1: CON1.19 (A01), IC4.8 (A1), IC11.11 (RS1), SV1.14, U1.14 (RS1), U$1.5 (A1)
A2: CON1.18 (A02), IC11.12 (RS2), SV1.15, U$1.6 (A2)
A3: SV1.16, U$1.7 (A3)
A4: SV1.17
A5: SV1.18
A6: SV1.19
A7: IC6.1 (A), SV1.20
A8: IC6.2 (B), SV1.21
A9: IC6.3 (C), SV1.22
A10: SV1.23
A11: SV1.24
A12: SV1.25
A13: SV1.26
A14: SV1.27
A15: SV1.28
ATN: IC1.6 (O), R14.1, R20.2
ATN_OUT: IC1.5 (I), IC4.40 (PA4)
CF_CS0: CON1.7 (/CS0), IC6.10 (Y5)
CLK: IC1.4 (O), IC4.23 (PB5), R13.1, R22.1
CLK_OUT: IC1.3 (I), IC4.39 (PA5)
CS_0: IC6.4 (G2A), SV1.37
CS_1: SV1.38
CS_2: SV1.39
CS_3: SV1.40
CS_4: SV1.32
CTS_RS232: IC2.8 (R2IN), X1.8
CTS_TTL: IC2.9 (R2OUT), U1.9 (CTS)
D0: CON1.21 (D00), IC3.12 (DB0), IC4.34 (D0), IC11.25 (D0), SV1.5, U1.18 (D0), U$1.14 (D0)
D1: CON1.22 (D01), IC3.13 (DB1), IC4.33 (D1), IC11.24 (D1), SV1.6, U1.19 (D1), U$1.13 (D1)
D2: CON1.23 (D02), IC3.14 (DB2), IC4.32 (D2), IC11.23 (D2), SV1.7, U1.20 (D2), U$1.12 (D2)
D3: CON1.2 (D03), IC3.15 (DB3), IC4.31 (D3), IC11.22 (D3), SV1.8, U1.21 (D3), U$1.11 (D3)
D4: CON1.3 (D04), IC3.16 (DB4), IC4.30 (D4), IC11.21 (D4), SV1.9, U1.22 (D4)
D5: CON1.4 (D05), IC3.17 (DB5), IC4.29 (D5), IC11.20 (D5), SV1.10, U1.23 (D5)
D6: CON1.5 (D06), IC3.18 (DB6), IC4.28 (D6), IC11.19 (D6), SV1.11, U1.24 (D6)
D7: CON1.6 (D07), IC3.19 (DB7), IC4.27 (D7), IC11.18 (D7), SV1.12, U1.25 (D7)
DATA: IC1.2 (O), IC4.24 (PB6), R12.1, R21.2
DATA_OUT: IC1.1 (I), IC4.38 (PA6)
FI2: IC11.17 (E), SV1.35, U1.27 (PH2)
GATE1: IC3.24 (P23), IC11.26 (G1)
GATE2: IC3.23 (P22), IC11.2 (G2)
GATE_SND: IC3.27 (P10), IC11.5 (G3)
GND: BATTERY_1.-, C1.2, C2.2, C3.2, C7.2, C8.2, C9.1, C10.-, C11.1, C12.1, C13.1, C14.2, C15.2, C16.2, C17.2, C18.-, C19.2, C20.1, C21.-, C22.1, C23.1, C24.2, CON1.1 (GND1), CON1.8 (A10), CON1.9 (/ATASEL), CON1.10 (A09), CON1.11 (A08), CON1.12 (A07), CON1.14 (A06), CON1.15 (A05), CON1.16 (A04), CON1.17 (A03), CON1.39 (/CSEL), CON1.50 (GND2), IC1.7 (GND), IC1.11 (I), IC1.13 (I), IC2.15 (GND), IC3.7 (EA), IC3.20 (VSS), IC4.7 (GND), IC5.7 (GND), IC5.9 (I), IC5.11 (I), IC5.13 (I), IC6.5 (G2B), IC6.8 (GND), IC11.1 (VSS), J1.4, J2.2, JP3.1, JP4.1, JP4.3, JP4.5, JP4.9, JP4.10, JP4.11, JP4.12, JP4.13, JP4.14, JP4.15, JP4.16, JP4.17, JP4.18, JP4.19, JP4.21, JP4.23, JP4.25, JP4.31, JP4.33, JP4.35, Q3.2 (S), QG1.7 (GND), U1.1 (VSS), U1.16 (DCD), U1.17 (DSR), U$1.9 (GND), X1.5
IRQ: IC11.9 (IRQ), SV1.30, U1.26 (IRQB), U$1.1 (STD.P)
KBD_CS: IC3.6 (CS), IC6.13 (Y2)
KCLK: C8.1, IC3.1 (T0), IC5.6 (O), J1.1, R7.1
KDAT: C7.1, IC3.39 (T1), IC5.2 (O), J1.2, R8.1
unnamed: C24.1, IC2.6 (V-)
unnamed: IC3.38 (P27/!DAK), IC5.3 (I)
unnamed: QG1.1 (TS), R1.1
unnamed: C4.2, IC2.1 (C1+)
unnamed: C5.2, IC2.4 (C2+)
unnamed: C5.1, IC2.5 (C2-)
unnamed: C4.1, IC2.3 (C1-)
unnamed: C6.1, IC2.2 (V+)
unnamed: C9.2, IC3.2 (XTAL1), Q2.2
unnamed: C11.2, IC3.3 (XTAL2), Q2.1
unnamed: IC3.37 (P26/!DRQ), IC5.5 (I)
unnamed: IC6.6 (G1), R9.1
unnamed: CON1.44 (/REG), R4.1
unnamed: CON1.36 (/WE), R3.1
unnamed: CON1.46 (/PDIAG), R5.1
unnamed: BATTERY_1.+, D1.A
unnamed: PAD1.1, Q3.3 (D)
unnamed: R10.2, U1.2 (CS0)
unnamed: CON1.32 (/CS1), R2.1
unnamed: IC11.6 (O3), R6.2
unnamed: IC11.16 (CS1), R15.1
unnamed: IC11.28 (C1), R16.2
unnamed: IC11.4 (C2), R17.2
unnamed: IC11.7 (C3), R18.2
unnamed: IC3.5 (SS), R19.1
unnamed: J2.3, R20.1
unnamed: J2.5, R21.1
unnamed: J2.4, R22.2
unnamed: IC5.1 (I), IC5.4 (O), R23.1
NMI: SV1.31
OUT_1: SV1.1
OUT_2: SV1.2
OUT_3: SV1.3
OUT_4: SV1.4
PA0: IC4.4 (PA0), JP4.8
PA1: IC4.3 (PA1), JP4.6
PA2: IC4.2 (PA2), JP4.4
PA3: IC4.1 (PA3), JP4.2
PA7: IC4.37 (PA7), JP4.7
PB0: IC4.18 (PB0), JP4.36
PB1: IC4.19 (PB1), JP4.38
PB2: IC4.20 (PB2), JP4.40
PB3: IC4.21 (PB3), JP4.39
PB4: IC4.22 (PB4), JP4.37
PC0: IC4.14 (PC0), JP4.28
PC1: IC4.15 (PC1), JP4.30
PC2: IC4.16 (PC2), JP4.32
PC3: IC4.17 (PC3), JP4.34
PC4: IC4.13 (PC4), JP4.26
PC5: IC4.12 (PC5), JP4.24
PC6: IC4.11 (PC6), JP4.22
PC7: IC4.10 (PC7), JP4.20
RD: CON1.34 (/IORD), IC3.8 (RD), IC4.5 (RD), SV1.33, U$1.8 (!RD)
RST: CON1.41 (/RESET), IC1.9 (I), IC3.4 (RESET), IC11.8 (RESET), SV1.29, U1.4 (RESB)
RST_INV: IC1.8 (O), IC4.35 (RESET), R11.1
RTC_CS: IC6.12 (Y3), U$1.2 (!CS0)
RTS_RS232: IC2.7 (T2OUT), X1.7
RTS_TTL: IC2.10 (T2IN), U1.8 (RTS)
RW: IC11.13 (R/!W), SV1.36, U1.28 (R/WB)
RXD_RS232: IC2.13 (R1IN), X1.2
RXD_TTL: IC2.12 (R1OUT), U1.12 (RXD)
SND_PULSE: Q3.1 (G), R6.1
SOSCI: C20.2, U$1.17 (!XT), X2.1
SOSCO: C23.2, U$1.16 (XT), X2.2
SRQ_IN: IC4.25 (PB7), J2.1
TIMER_CS: IC6.14 (Y1), IC11.15 (CS0)
TXD_RS232: IC2.14 (T1OUT), X1.3
TXD_TTL: IC2.11 (T1IN), U1.10 (TXD)
UART_CLK: QG1.8 (OUT), U1.6 (XTL1)
UART_CS: IC6.15 (Y0), U1.3 (CS1B)
VCC: C1.1, C2.1, C3.1, C6.2, C10.+, C12.2, C14.1, C15.1, C16.1, C17.1, C19.1, C21.+, C22.2, CON1.13 (VCC2), CON1.38 (VCC1), D2.A, IC1.14 (VCC), IC2.16 (VCC), IC3.25 (PROG), IC3.26 (VDD), IC3.40 (VCC), IC4.26 (VCC), IC5.14 (VCC), IC6.16 (VCC), IC11.14 (VCC), J1.5, JP3.2, PAD2.1, QG1.14 (VCC), R1.2, R2.2, R3.2, R4.2, R5.2, R7.2, R8.2, R9.2, R10.1, R11.2, R12.2, R13.2, R14.2, R15.2, R16.1, R17.1, R18.1, R19.2, R23.2, U1.15 (VDD), U$1.3 (ALE), U$1.15 (CS1)
VPA: C13.2, C18.+, D1.C, D2.C, U$1.18 (VDD)
WR: CON1.35 (/IOWR), IC3.10 (WR), IC4.36 (WR), SV1.34, U$1.10 (!WR)

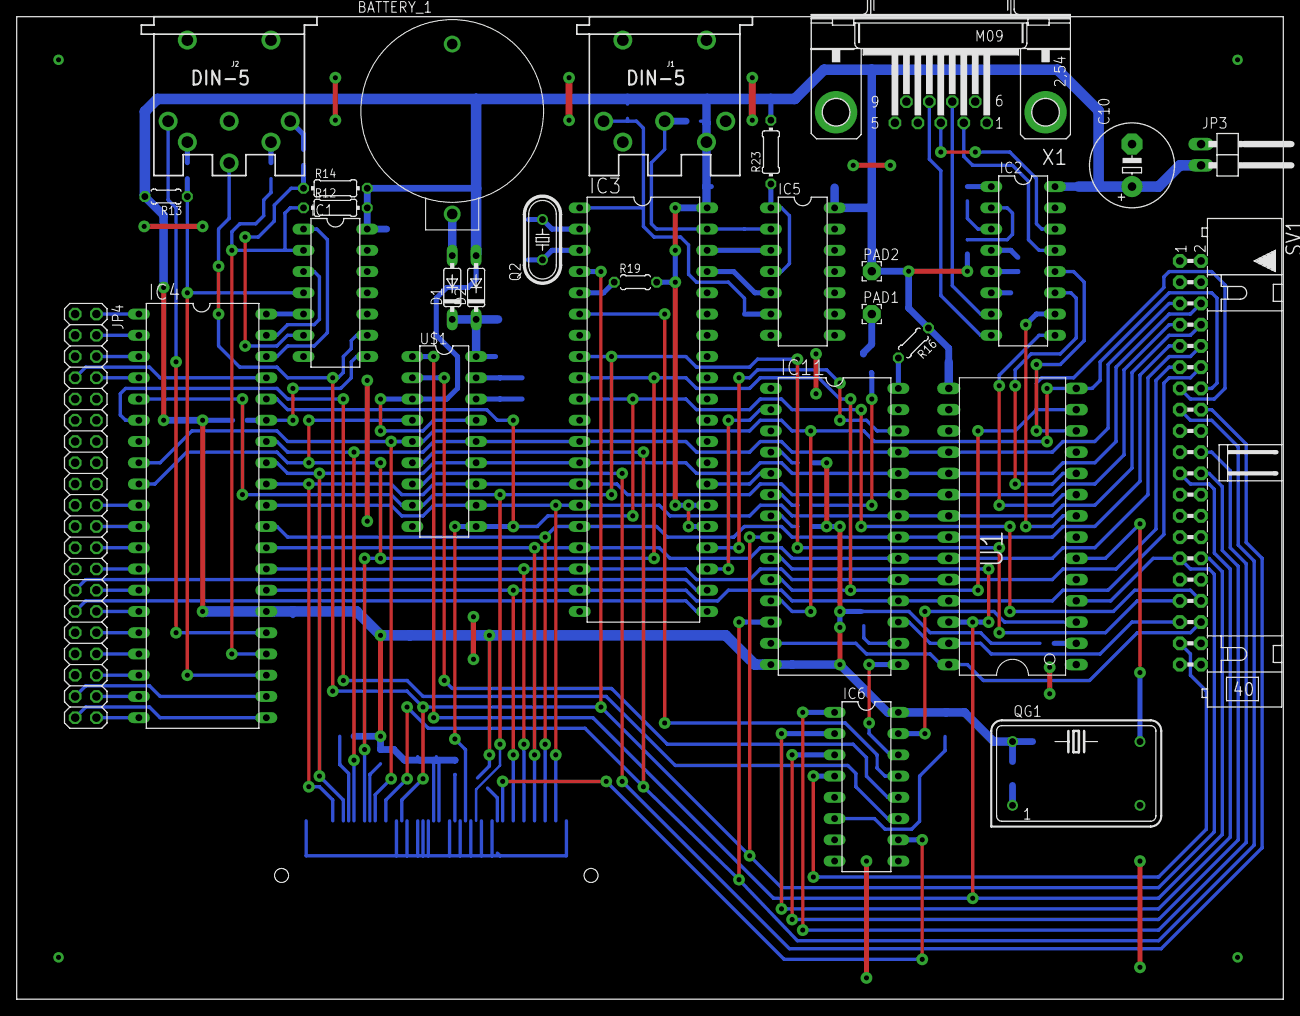
[picture p9: board io_board.brd from above]

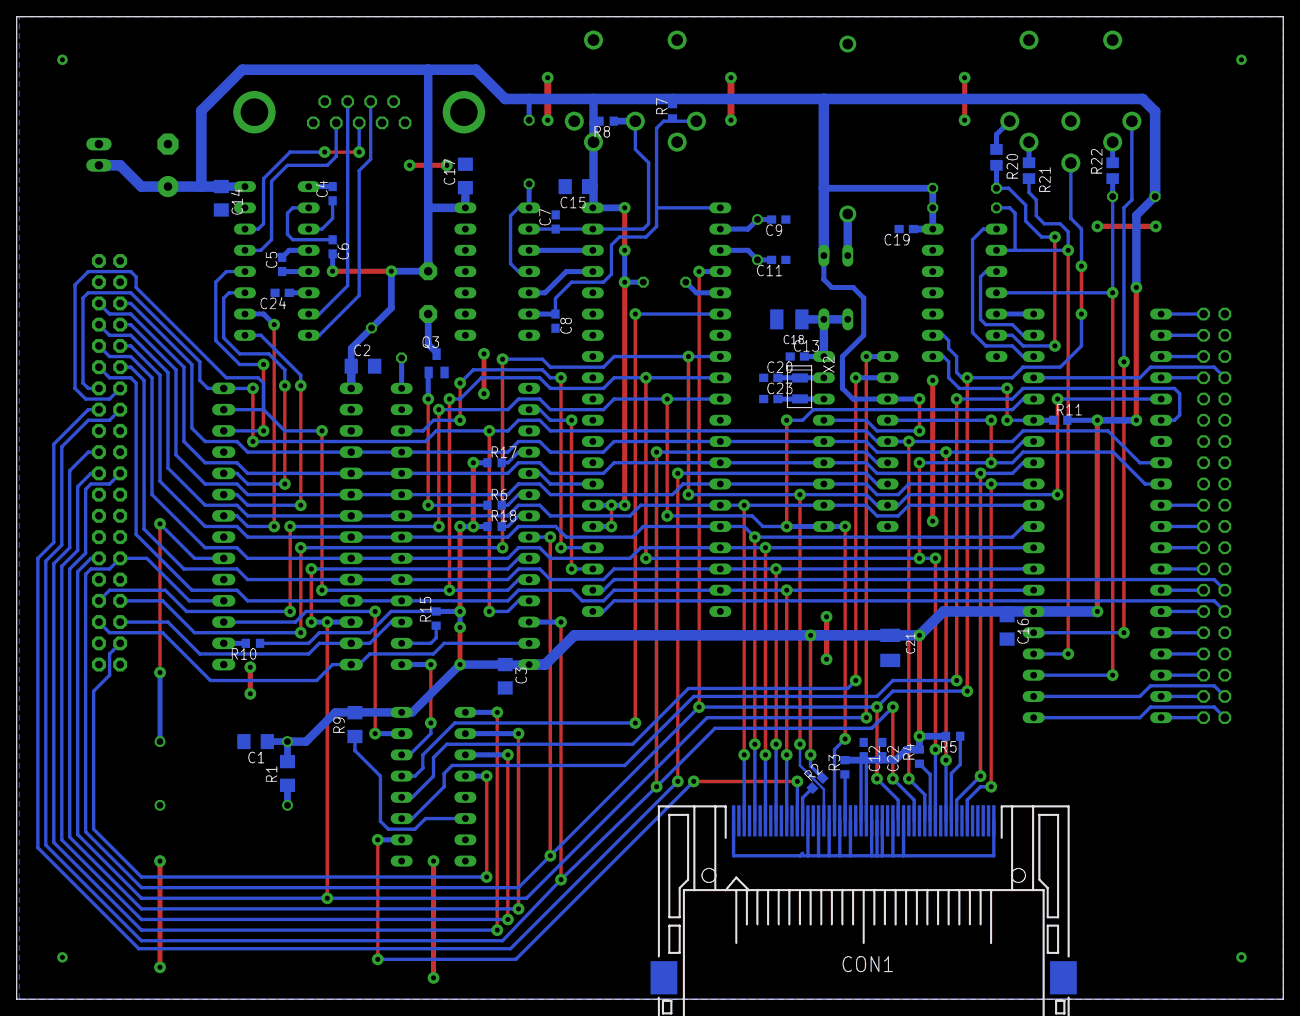
[picture p10: board io_board.brd from below]

Board: 2 copper layers, 151.4 x 117.5 mm, 72 parts (43 on the bottom side), 105 nets.
